lshw/prc/README.md

PC远程控制卡  

用W5500 10M/100M网卡，把电脑的串口挂在tcp的端口上，方便linux的远程维护。  
还可以控制reset和power按键，提供一路20A的电压输出，提供机箱温度检测，  
支持最多32个温度探头。  
  
输入电压5-30V  

串口速率支持300-921600Bps

开发环境：arduino 

对debian的mips编译机集群捐助了7台，工作良好  

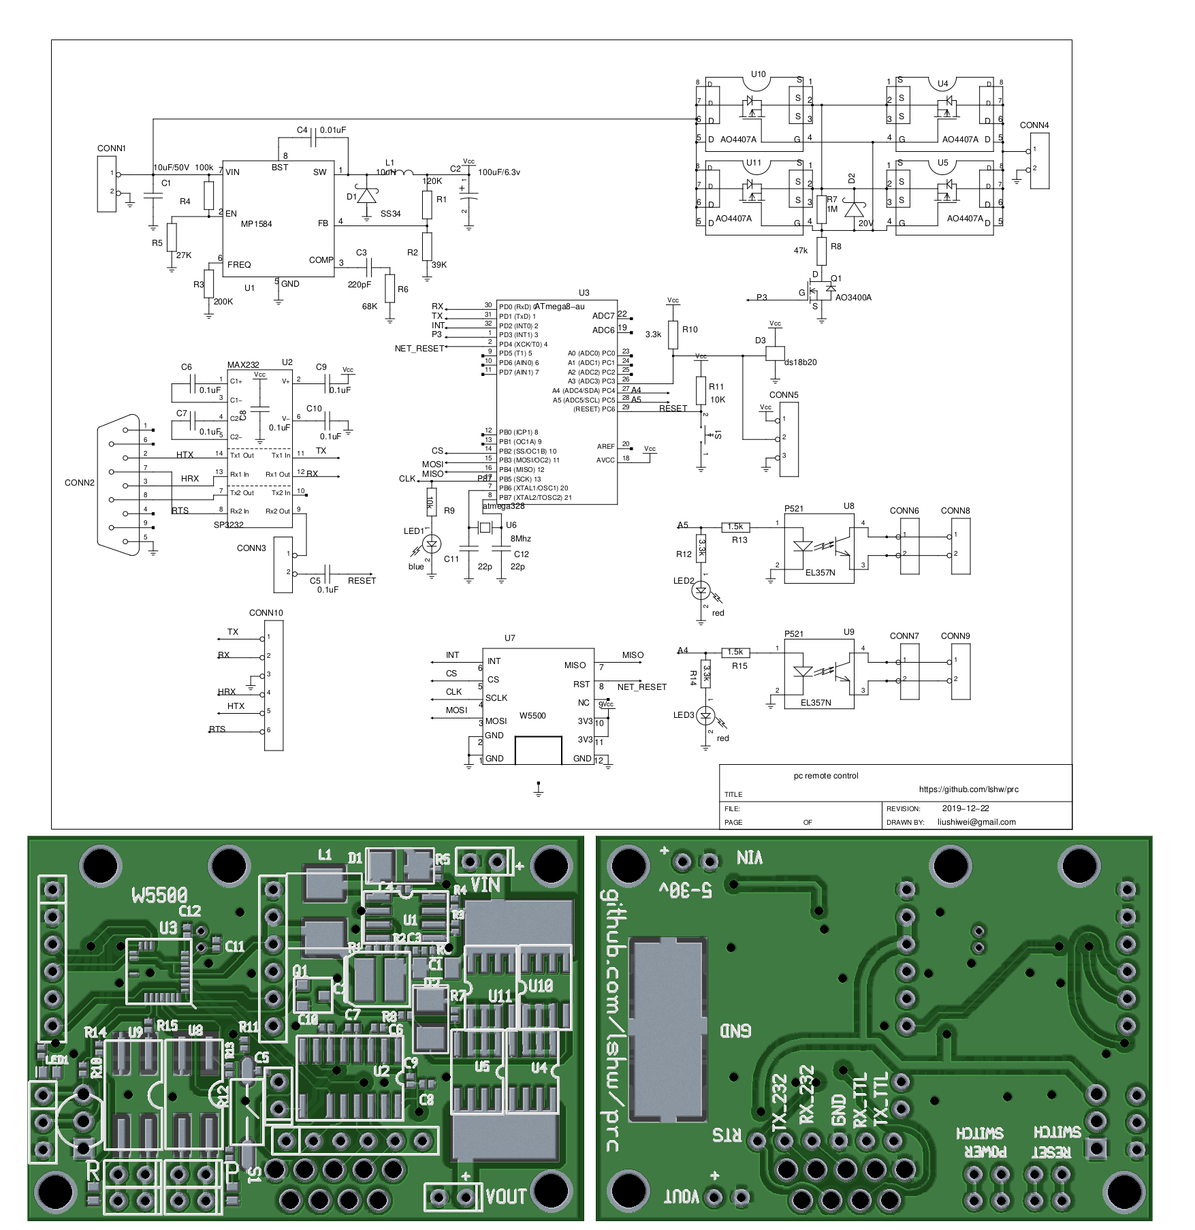
[picture p1: control.png]
  

淘宝链接:https://item.taobao.com/item.htm?id=611681003797

淘宝店铺:https://shop316166779.taobao.com
