lshw/prc/link.txt

9针公座	9针母座	6P串口	说明
5	5	3	地
2	3	4	TX
3	2	5	RX
8	7	6	DTR
