lshw/prc/com.pdf

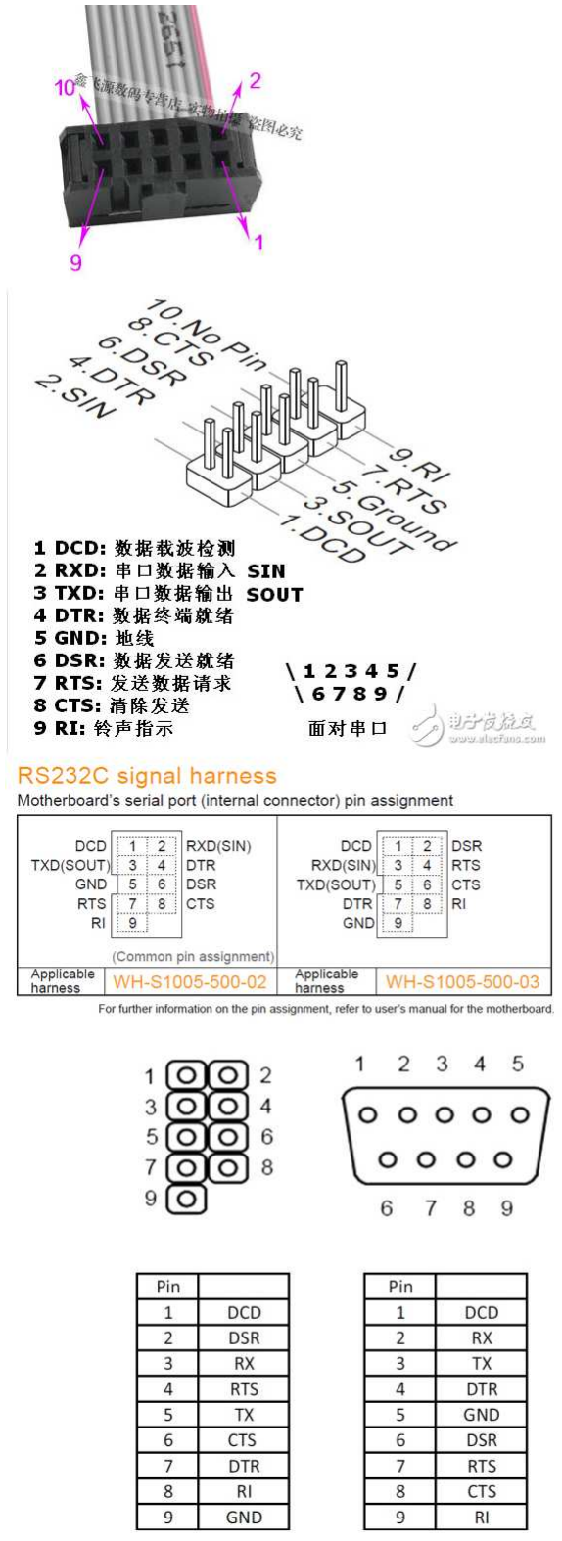
[picture p2: figure]
