lshw/prc/w5500.pdf

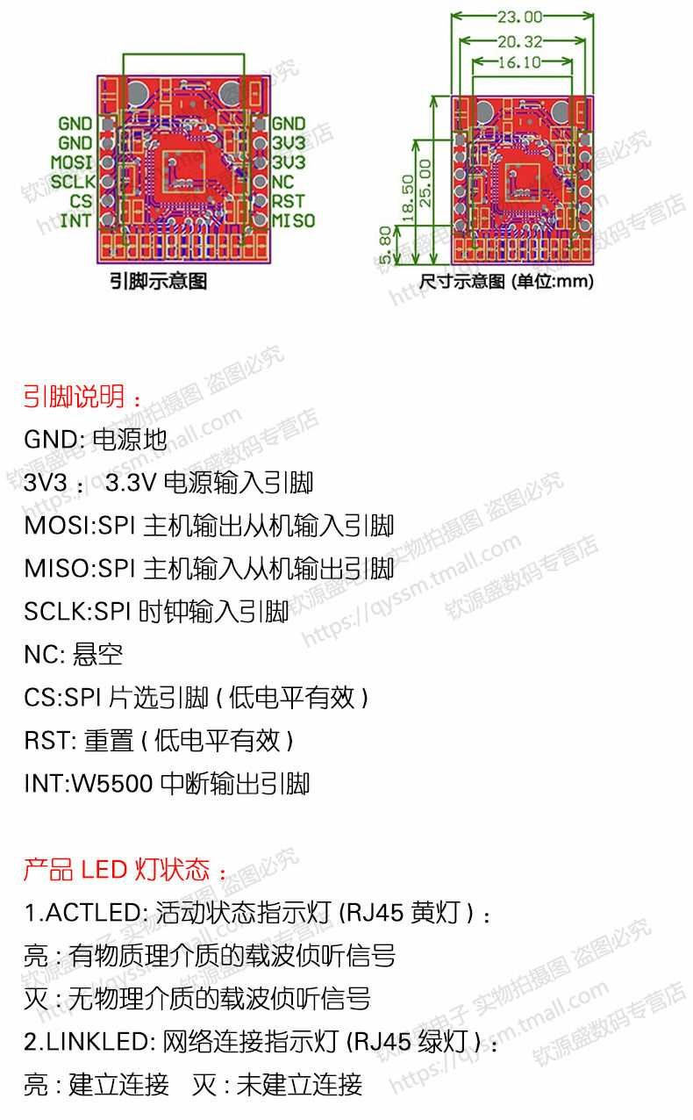
[picture p3: page 1]
