lshw/prc/control1_bom.csv

Quantity | Footprint | Comment | Description | 编号
2 | 0402 | 22pF | C11 C12 | C1555
1 | DO-214AA | 10uH | L1 | C139506
1 | 0402 | 68k | R6 | C36871
7 | 0402 | 100nF | C8 C9 C4 C5 C10 C7 C6 | C1525
4 | 0402 | 10k | R9 R11 R12 R14 | C25744
1 | 0603 | blue | LED1 | C72041
2 | so4 | EL357N | U8 U9 | C6649
1 | 1206 | 10uF/50V | C1 | C13585
1 | 0402 | 3.3k | R10 | C25890
1 | 0805 | 20V | D2 | C327523
2 | 0402 | 1.5k | R15 R13 | C25867
2 | 0603 | red | LED3 LED2 | C2286
1 | 0402 | 1M | R7 | C26083
1 | 0402 | 47k | R8 | C25792
4 | SO8 | AO4407A | U4 U5 U10 U11 | C16072
1 | EIA3528 | 100uF/6.3v | C2 | C16133
1 | SOT23 | AO3400A | Q1 | C20917
1 | 0402 | 200k | R3 | C25764
1 | 0402 | 27k | R5 | C25771
1 | 0402 | 100k | R4 | C25741
1 | DO-214AA | SS34 | D1 | C84635
1 | 0402 | 120k | R1 | C25750
1 | 0402 | 39k | R2 | C25783
1 | 0402 | 220pF | C3 | C1530
1 | SO8 | MP1584 | U1 | C15051
1 | SSOP16 | SP3232 | U2 | C13482
1 | TQFP32_7 | atmega328pb | U3 | C132230
