lshw/prc/control.pdf

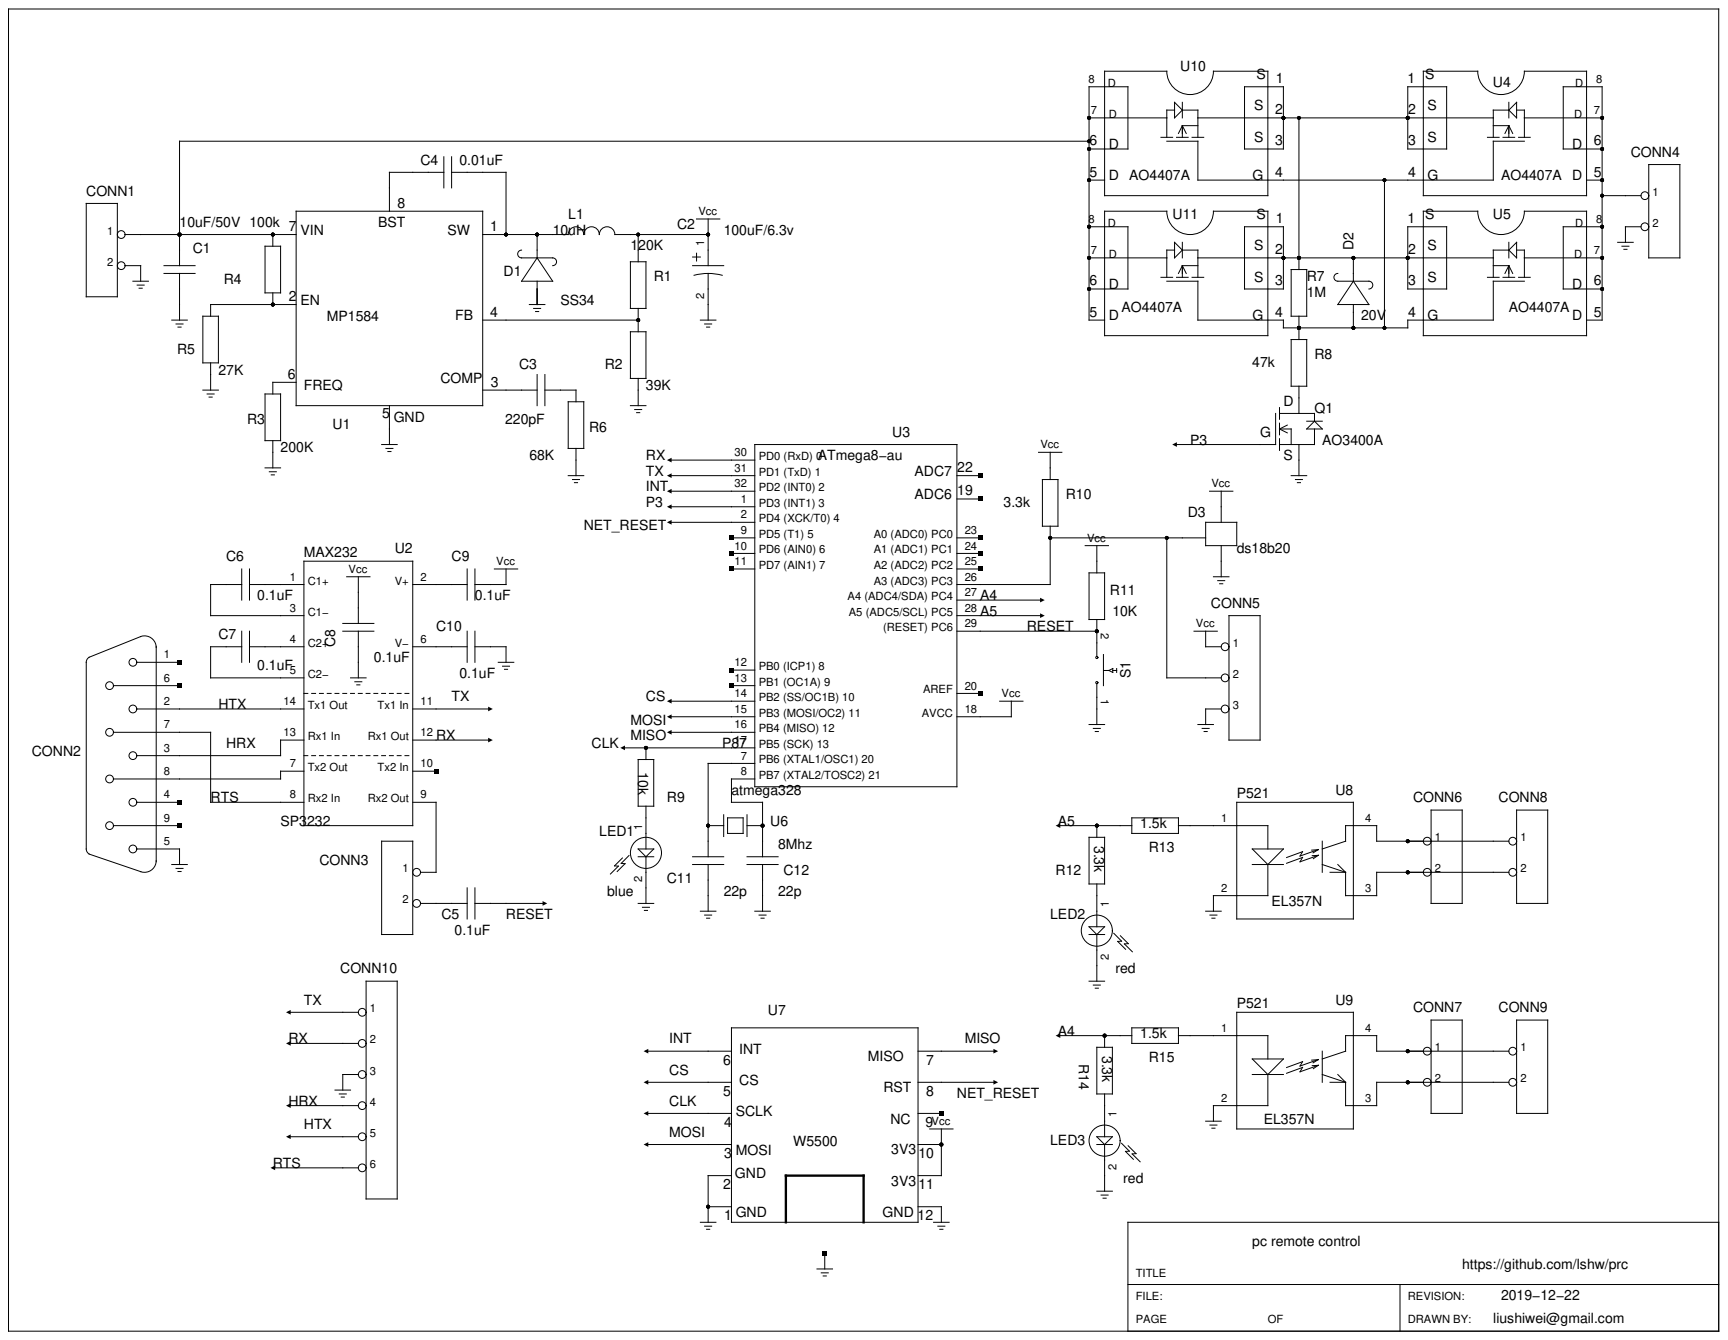
[picture p4: page 1]

https://github.com/lshw/prc
