lshw/prc/(list of files, drawings)

Other design files:
control1.pcb
control2.pcb
control.pcb
