lshw/prc/(commit log)

2019-12-22 增加S1复位开关
    [control.pcb, control.sch]
2019-12-22 mos管背靠背，防止电源进出接反,通过寄生二极管损坏mos管
    [control.pcb, control.sch]
2019-12-22 根据嘉立创的规范， 调整元件型号和方向
    [control.pcb, control.sch, control_bom.csv, control_xy.csv]
2019-12-23 w5500封装
2019-12-23 最终pcb稿 20191222
    [control.pcb, control.sch, control_bom.csv, control_xy.csv]
2019-12-23 fix bom xy file
    [control_bom.csv, control_xy.csv]
2019-12-23 修改cpu 封装格式
    [control1.pcb, control1.sch, control1_bom.csv, control1_xy.csv]
2019-12-28 根据贴片进行调整
    [control.pcb, control.sch, control1.pcb, control1.sch, control1_bom.csv, control1_xy.csv, control_bom.csv, control_xy.csv]
2019-12-30 ardino程序
    [control1.pcb, control1.sch, control1_bom.csv, control1_xy.csv]
2020-01-01 w5500测试
2020-01-01 调整pcb
    [control2.pcb]
2020-01-01 初步的RJ45-串口透传程序
2020-01-21 firmware升级脚本
2020-01-31 成品样机完成,增加淘宝链接
